bcbergmanuu/audio-bio-semi/scope.jpg

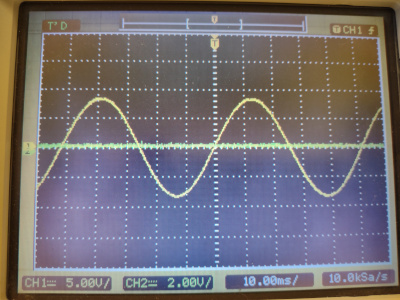
scope.jpg
