bcbergmanuu/audio-bio-semi/audio-ext.sch

## EAGLE design audio-ext.sch (2022-04-26)

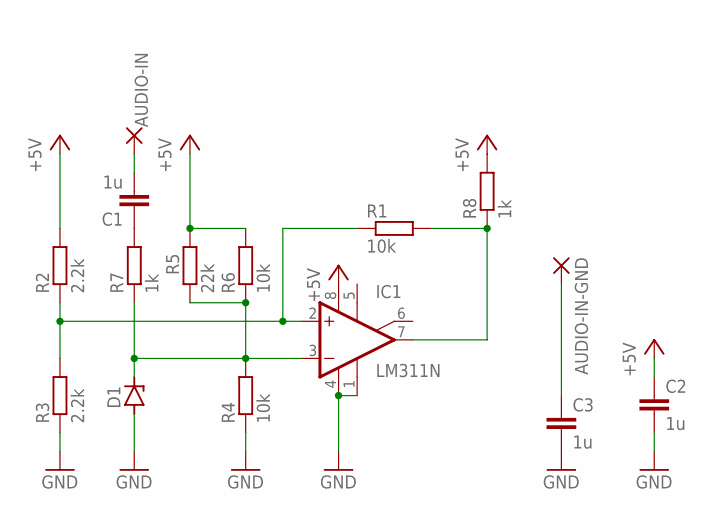
[picture p5: schematic audio-ext.sch]

Parts:
AUDIO-IN: WIREPAD1,6/0,8; 1,6/0,8
AUDIO-IN-GND: WIREPAD1,6/0,8; 1,6/0,8
C1, C2, C3: 1u; C0805
D1: ZENER-DIODESOT23; SOT23
IC1: LM311N; DIL08
R1, R4, R6: 10k; R0805
R2, R3: 2.2k; R0805
R5: 22k; R0805
R7, R8: 1k; R0805

Connections:
+5V: C2.1, IC1.8 (V+), R2.2, R5.2, R6.2, R8.2
GND: C2.2, C3.2, D1.1 (A), IC1.1 (GND), IC1.4 (V-), R3.1, R4.1
unnamed: AUDIO-IN.1, C1.2
unnamed: AUDIO-IN-GND.1, C3.1
unnamed: C1.1, R7.2
unnamed: IC1.7 (OUT), R1.2, R8.1
unnamed: IC1.2 (+IN), R1.1, R2.1, R3.2
unnamed: D1.3 (C), IC1.3 (-IN), R4.2, R5.1, R6.1, R7.1
