bcbergmanuu/audio-bio-semi/triggerbox.sch

## EAGLE design triggerbox.sch (2022-04-05)

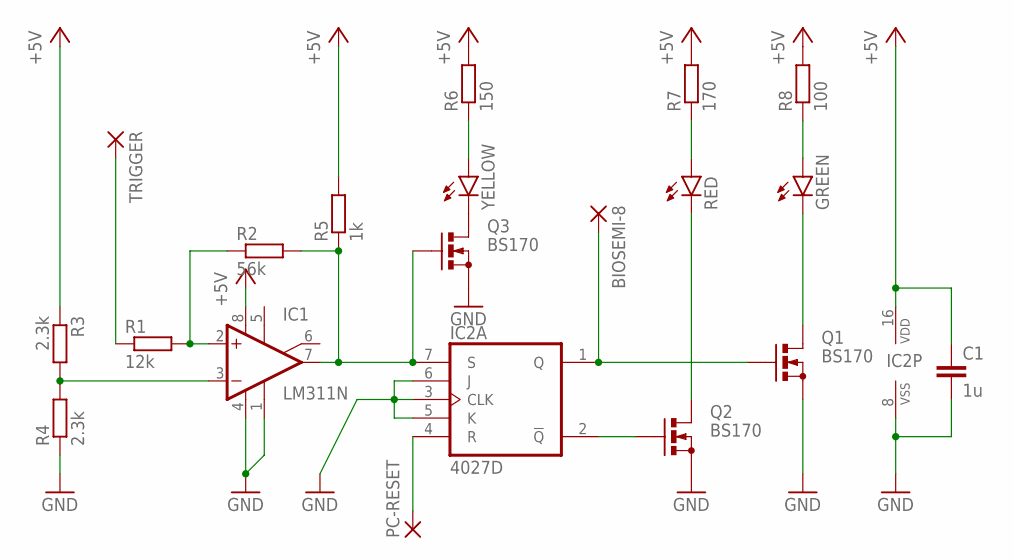
[picture p6: schematic triggerbox.sch]

Parts:
BIOSEMI-8: WIREPAD1,6/0,8; 1,6/0,8
C1: 1u; C0805
GREEN: LED5MM
IC1: LM311N; DIL08
IC2: 4027D; SO16
PC-RESET: WIREPAD1,6/0,8; 1,6/0,8
Q1, Q2, Q3: BS170; SOT54E
R1: 12k; R0805
R2: 56k; R0805
R3, R4: 2.3k; R0805
R5: 1k; R0805
R6: 150; R0805
R7: 170; R0805
R8: 100; R0805
RED: LED5MM
TRIGGER: WIREPAD1,6/0,8; 1,6/0,8
YELLOW: LED5MM

Connections:
+5V: C1.1, IC1.8 (V+), IC2.16 (VDD), R3.1, R5.2, R6.2, R7.2, R8.2
GND: C1.2, IC1.1 (GND), IC1.4 (V-), IC2.3 (CLK), IC2.5 (K), IC2.6 (J), IC2.8 (VSS), Q1.S, Q2.S, Q3.S, R4.1
unnamed: IC1.3 (-IN), R3.2, R4.2
unnamed: IC1.2 (+IN), R1.2, R2.1
unnamed: IC1.7 (OUT), IC2.7 (S), Q3.G, R2.2, R5.1
unnamed: IC2.2 (!Q), Q2.G
unnamed: R1.1, TRIGGER.1
unnamed: IC2.4 (R), PC-RESET.1
unnamed: BIOSEMI-8.1, IC2.1 (Q), Q1.G
unnamed: Q3.D, YELLOW.K (C)
unnamed: R6.1, YELLOW.A
unnamed: R7.1, RED.A
unnamed: GREEN.A, R8.1
unnamed: Q2.D, RED.K (C)
unnamed: GREEN.K (C), Q1.D
