bcbergmanuu/audio-bio-semi/(commit log)

2021-09-14 added schematic
2022-04-05 schematic triggerbox
    [triggerbox.sch]
2022-04-05 schematic triggerbox2
    [triggerbox.sch]
2022-04-05 schematic triggerbox3
    [triggerbox.sch]
2022-04-06 schematic audio
    [audio-ext.sch]
2022-04-26 overvoltage protect
    [audio-ext.sch]
